esdkrwl/IT2School-MocoMoco/Hardware/Datenblätter/Connector.jpg

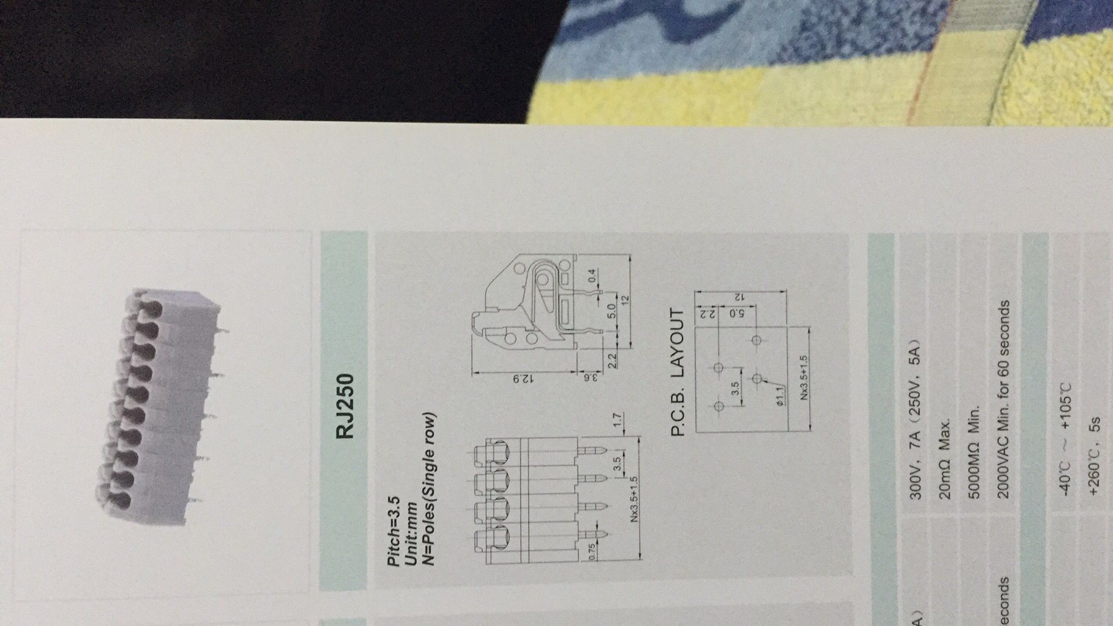
Hardware/Datenblätter/Connector.jpg
