esdkrwl/IT2School-MocoMoco/Hardware/Datenblätter/4T5RYBHD5`LG)1CY@NV_Q17.jpg

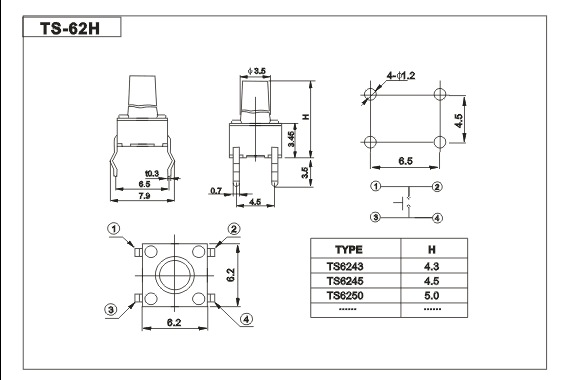
Hardware/Datenblätter/4T5RYBHD5`LG)1CY@NV_Q17.jpg
