esdkrwl/IT2School-MocoMoco/Hardware/Datenblätter/DBCB8189@899B2E73.F9656156.jpg

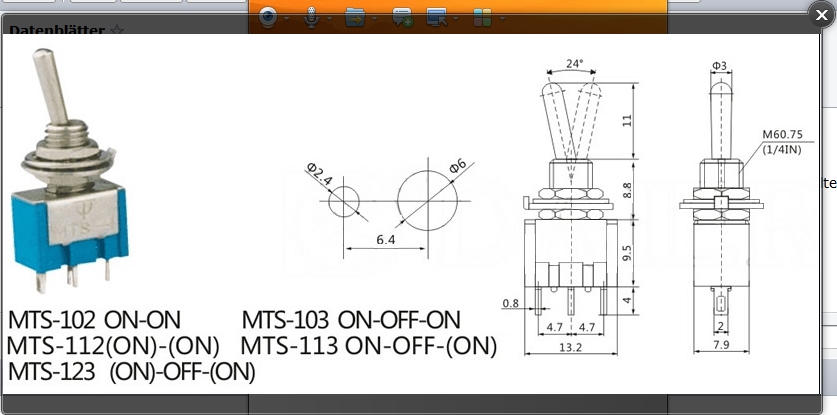
Hardware/Datenblätter/DBCB8189@899B2E73.F9656156.jpg
