esdkrwl/IT2School-MocoMoco/Hardware/Datenblätter/Quarz.png

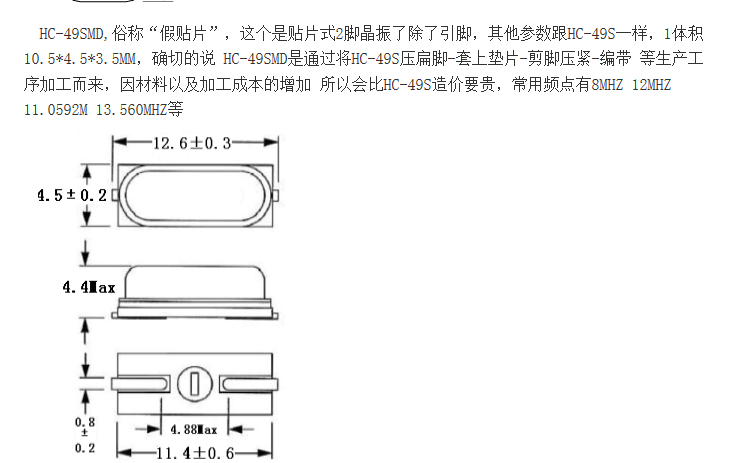
Hardware/Datenblätter/Quarz.png
