esdkrwl/IT2School-MocoMoco/Hardware/MocoMoco - Partlist.xlsx

 | Stückliste zum MocoMoco
 | Version 1.2
 | Part | Value | Package | Bemerkung
 | AK1 |  | 2-pol | graue Klemme - Muster
 | AK2 |  | 11-pol | graue Klemme - Muster
 | C1-C11 | 68nF | C0805K
 | C12-C13 | 100nF | C0805K
 | C14-C15 | 22pF | C0805K
 | C16 | 4,7µF | C3216 | ELKO
 | D1-D2 | 3V6 | SOT-23 / TO236
!!! | IC1 | MEGA32-A | TQFP44 | has to be programmed! NEW
 | LED1 | green | 0603 | PC-DA0603UGK-520D10
 | Q1 | 12MHz | HC49UP | Q-12,00000M-HC49USSMD-F3030D20
 | R1-R12 | 2,2K | R0603
 | R13-R14 | 68 | R0603
 | R15 | 10K | R0603
 | R16 | 10K | LI10 | Poti mit Steckachse
!!! | R17 | 2,2K | R0603
 | ISP |  | pad only | kein Bauteil, nur Lötpads
!!! | S1 |  | TS-62H | Taster
 | USB |  | A01SB141B1-292 | Mikro USB-Buchse
