esdkrwl/IT2School-MocoMoco/Hardware/MocoMoco Schematic.pdf

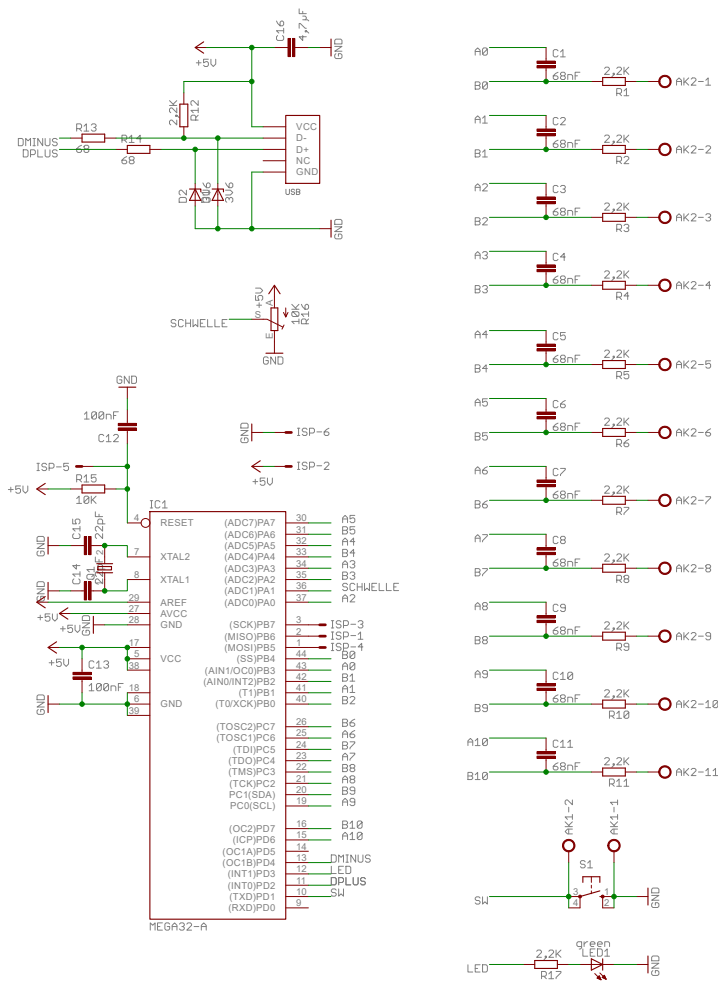
[picture p12: page 1]
(ADC7)PA7; (ADC6)PA6; (ADC5)PA5; (ADC4)PA4; (ADC3)PA3; (ADC2)PA2; (ADC1)PA1; (ADC0)PA0; (SCK)PB7; (MISO)PB6; (MOSI)PB5; (AIN1/OC0)PB3; (AIN0/INT2)PB2; (T0/XCK)PB0; (TOSC2)PC7; (TOSC1)PC6; (TDI)PC5; (TDO)PC4; (TMS)PC3; (TCK)PC2; PC1(SDA); PC0(SCL); GND 28; AVCC 27; AREF 29; XTAL1; XTAL2; RESET; (RXD)PD0; 9 (TXD)PD1; 10 (INT0)PD2; 11 (INT1)PD3; 14 (ICP)PD6; VCC; GND; VCC D- D+ NC GND
