esdkrwl/IT2School-MocoMoco/Hardware/MocoMoco.brd

## EAGLE design Hardware/MocoMoco.brd (2022-11-03)

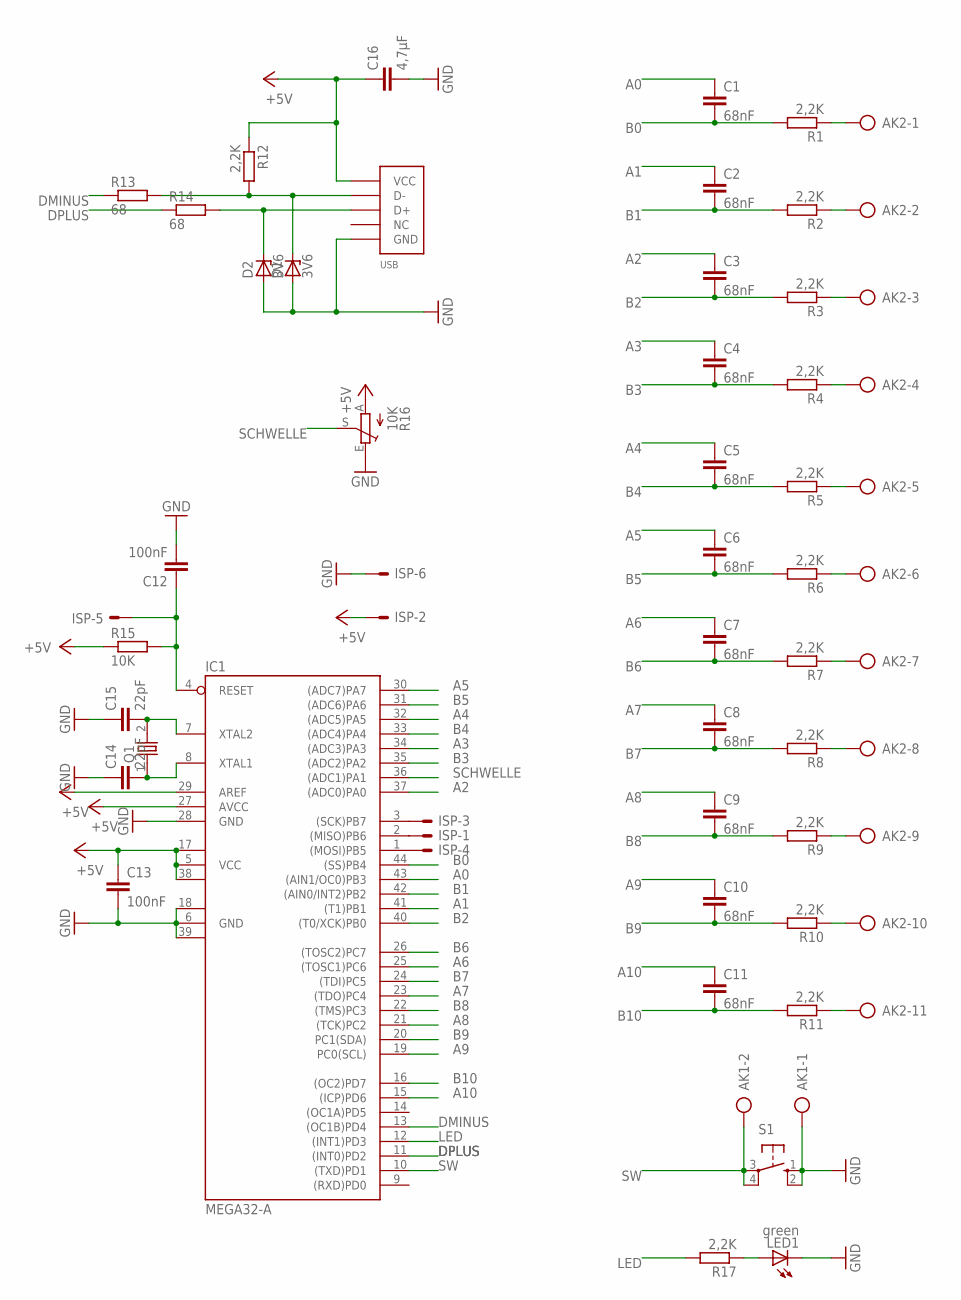
[picture p13: schematic MocoMoco.sch]

Parts:
AK1: AK2; AK/2
AK2: AK11; AK/11
C1, C2, C3, C4, C5, C6, C7, C8, C9, C10, C11: 68nF; C0805K
C12, C13: 100nF; C0805K
C14, C15: 22pF; C0805K
C16: 4,7µF; C3216
D1, D2: 3V6; TO236
IC1: MEGA32-A; TQFP44
ISP: ML6E; ML6
LED1: green; CHIP-LED0603
Q1: HC-49/US; HC49UP
R1, R2, R3, R4, R5, R6, R7, R8, R9, R10, R11, R12, R17: 2,2K; R0603
R13, R14: 68; R0603
R15: 10K; R0603
R16: 10K; LI10
S1: 10-XX; B3F-10XX
USB: MICRO_USB; MICRO_USB_A01SB141B1-292

Connections:
+5V: C13.1, C16.1, IC1.5 (VCC), IC1.17 (VCC1), IC1.27 (AVCC), IC1.29 (AREF), IC1.38 (VCC2), ISP.2, R12.1, R15.1, R16.A, USB.P$1 (VCC)
A0: C1.1, IC1.43 ((AIN1/OC0)PB3)
A1: C2.1, IC1.41 ((T1)PB1)
A2: C3.1, IC1.37 ((ADC0)PA0)
A3: C4.1, IC1.34 ((ADC3)PA3)
A4: C5.1, IC1.32 ((ADC5)PA5)
A5: C6.1, IC1.30 ((ADC7)PA7)
A6: C7.1, IC1.25 ((TOSC1)PC6)
A7: C8.1, IC1.23 ((TDO)PC4)
A8: C9.1, IC1.21 ((TCK)PC2)
A9: C10.1, IC1.19 (PC0(SCL))
A10: C11.1, IC1.15 ((ICP)PD6)
B0: C1.2, IC1.44 ((SS)PB4), R1.2
B1: C2.2, IC1.42 ((AIN0/INT2)PB2), R2.2
B2: C3.2, IC1.40 ((T0/XCK)PB0), R3.2
B3: C4.2, IC1.35 ((ADC2)PA2), R4.2
B4: C5.2, IC1.33 ((ADC4)PA4), R5.2
B5: C6.2, IC1.31 ((ADC6)PA6), R6.2
B6: C7.2, IC1.26 ((TOSC2)PC7), R7.2
B7: C8.2, IC1.24 ((TDI)PC5), R8.2
B8: C9.2, IC1.22 ((TMS)PC3), R9.2
B9: C10.2, IC1.20 (PC1(SDA)), R10.2
B10: C11.2, IC1.16 ((OC2)PD7), R11.2
DMINUS: IC1.13 ((OC1B)PD4), R13.1
DPLUS: IC1.11 ((INT0)PD2), R14.1
GND: AK1.1, C12.2, C13.2, C14.1, C15.1, C16.2, D1.A, D2.A, IC1.6 (GND), IC1.18 (GND1), IC1.28 (GND), IC1.39 (GND2), ISP.6, LED1.C, R16.E, S1.1 (S), S1.2 (S1), USB.P$5 (GND)
LED: IC1.12 ((INT1)PD3), R17.2
unnamed: AK2.1, R1.1
unnamed: AK2.2, R2.1
unnamed: C15.2, IC1.7 (XTAL2), Q1.2
unnamed: AK2.4, R4.1
unnamed: D1.C, R12.2, R13.2, USB.P$2 (D-)
unnamed: AK2.5, R5.1
unnamed: AK2.6, R6.1
unnamed: D2.C, R14.2, USB.P$3 (D+)
unnamed: AK2.7, R7.1
unnamed: IC1.1 ((MOSI)PB5), ISP.4
unnamed: IC1.3 ((SCK)PB7), ISP.3
unnamed: AK2.8, R8.1
unnamed: C12.1, IC1.4 (RESET), ISP.5, R15.2
unnamed: IC1.2 ((MISO)PB6), ISP.1
unnamed: AK2.9, R9.1
unnamed: AK2.10, R10.1
unnamed: AK2.11, R11.1
unnamed: AK2.3, R3.1
unnamed: C14.2, IC1.8 (XTAL1), Q1.1
unnamed: LED1.A, R17.1
SCHWELLE: IC1.36 ((ADC1)PA1), R16.S
SW: AK1.2, IC1.10 ((TXD)PD1), S1.3, S1.4 (P1)

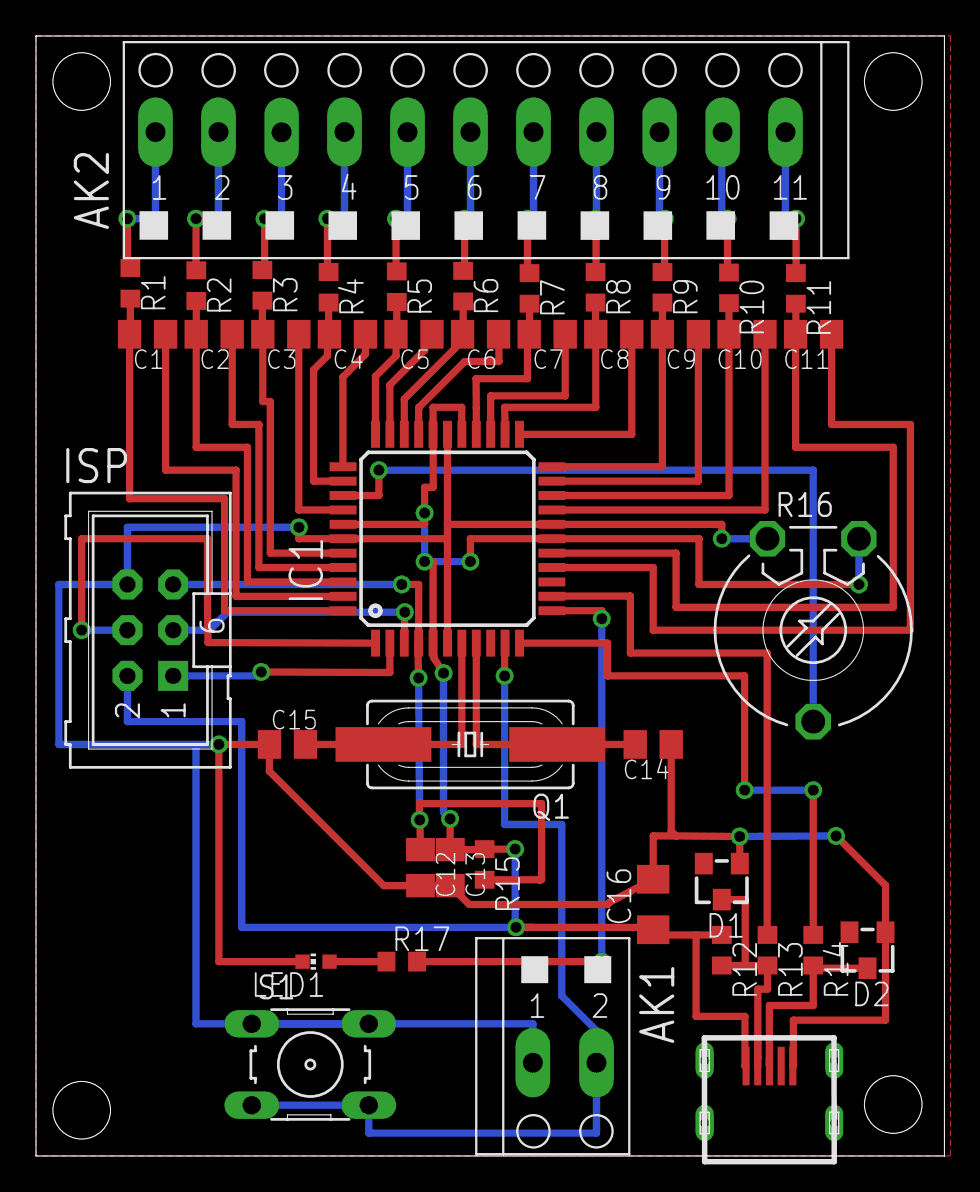
[picture p14: board MocoMoco.brd from above]

Board: 2 copper layers, 50.5 x 62.2 mm, 43 parts (0 on the bottom side), 49 nets.
