esdkrwl/IT2School-MocoMoco/(notices)

Notices in the files:
Hardware/MocoMoco.brd:
copyright Tobias Stuckenberg
